Entrind/Web-KP-PomJen/Prototype_Alat/Flowchart_Alat.jpg

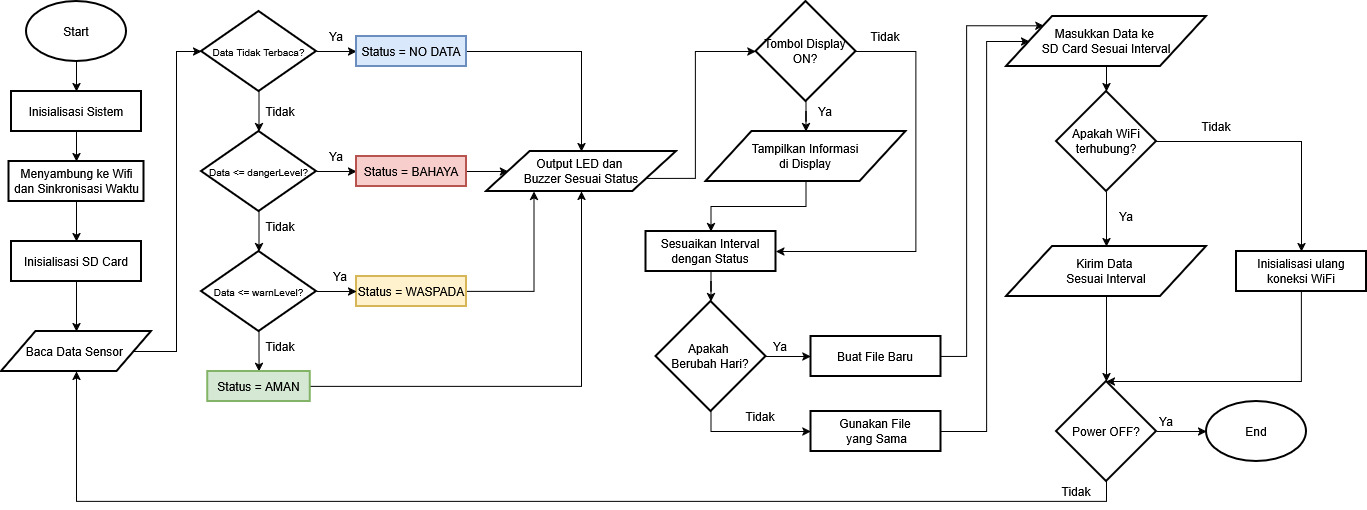
Prototype_Alat/Flowchart_Alat.jpg
