Entrind/Web-KP-PomJen/Prototype_Alat/Wiring Table.pdf

## Wiring Table

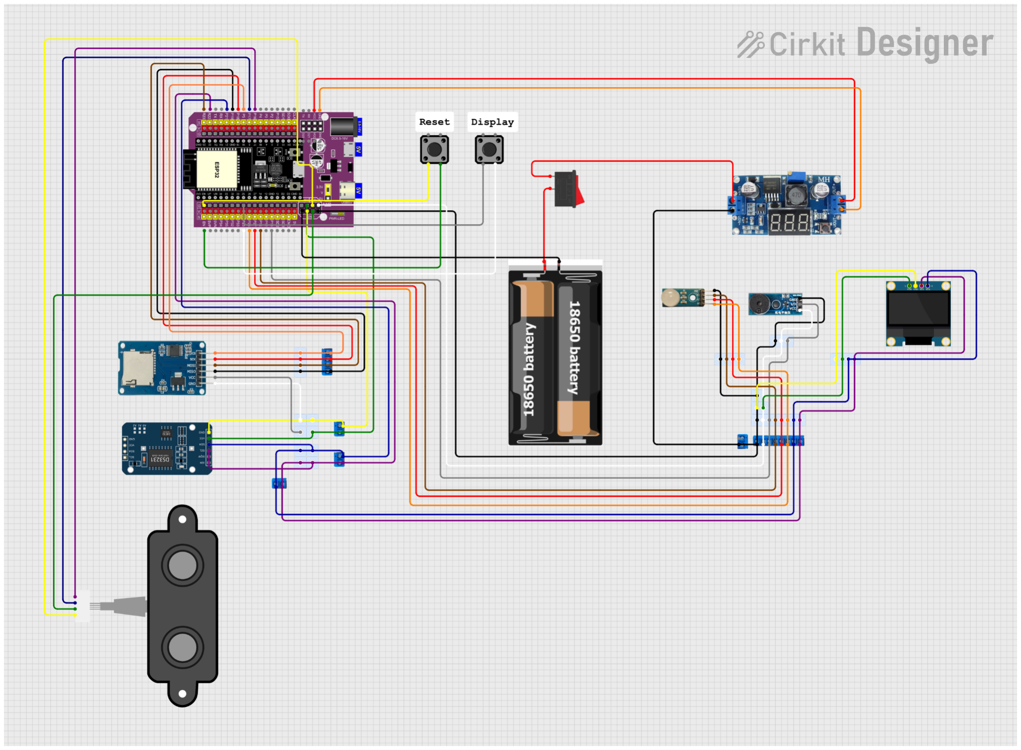
[picture p2: figure]

Komponen | PIN

Battery Case

Battery Case vin | Switch Pin 1
Battery Case ground | GND

LM2596 Step Down Converter

VIN+ | Switch Pin 2
VIN- | GND
VOUT+ | VCC
VOUT- | GND

SSD 1306 OLED Display

VCC | 3.3V
GND | GND
SCL | P22
SDA | P21

RGB LED

GND | GND
R | P14
G | P27
B | P26

Passive Buzzer

GND | GND
I/O | P13
VCC | 3.3V

SD Card Reader

CS | P5
SCK | P18
MOSI | P23
MISO | P19
VCC | 5V
GND | GND

RTC DS3231

GND | GND
VCC | 5V
SDA | P21
SCL | P22

Sensor Ultrasonik A02YYUW

VCC | 3.3V
GND | GND
RX | P17
TX | P16

Reset Button

Pin 1 | GND
Pin 2 | EN

Display Button

Pin 1 | GND
Pin 2 | P25
