Entrind/Web-KP-PomJen/Prototype_Alat/Ultrasonic Datalogger Wiring Diagram.png

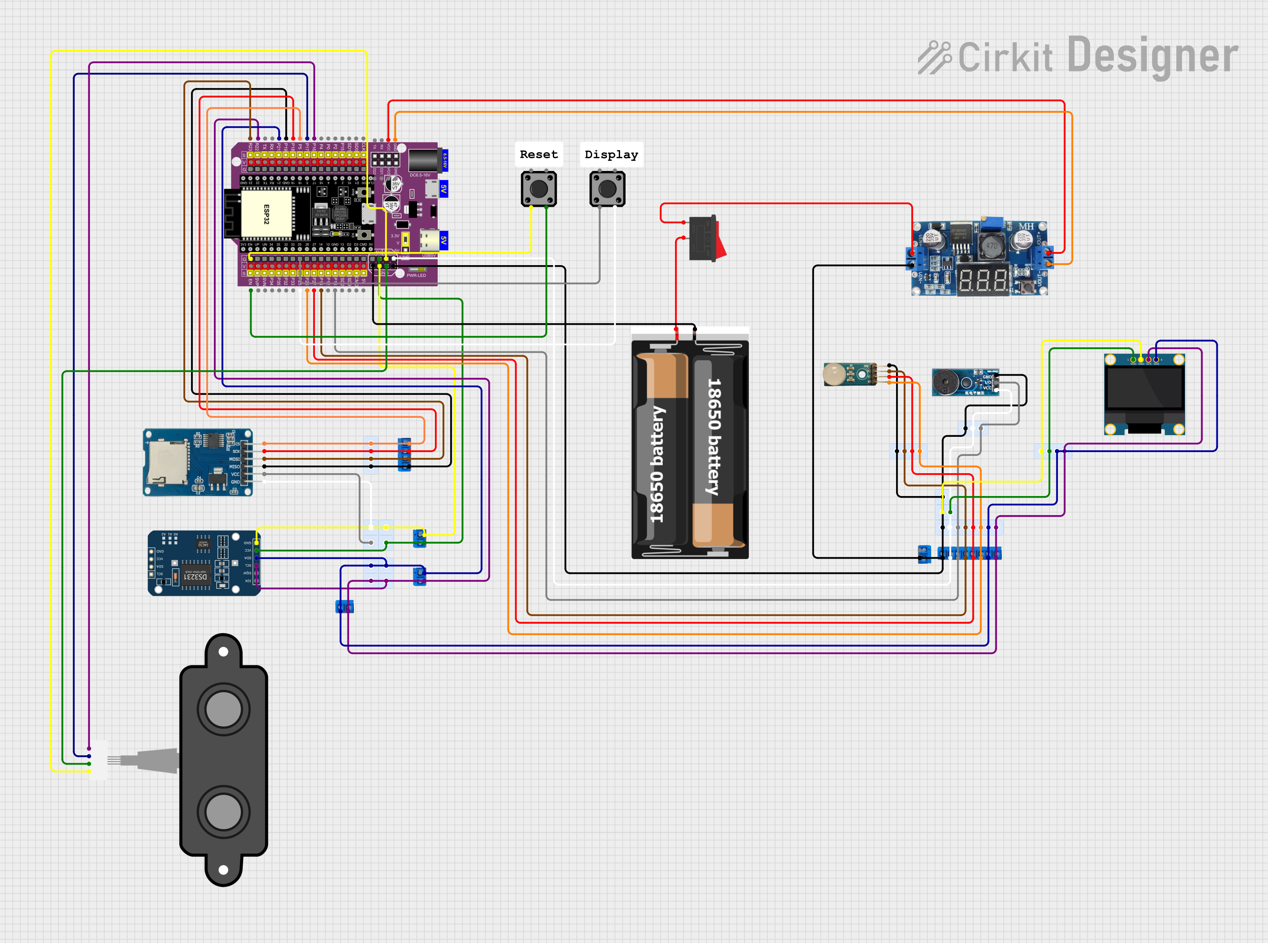
Prototype_Alat/Ultrasonic Datalogger Wiring Diagram.png
