Entrind/Web-KP-PomJen/(commit log)

2025-11-12 chore(ui): integrate Tailwind CSS v3 and apply base layout styles Configured tailwind.config.js and postcss.config.js, added index.css with Tailwind directives, and wired import in main.jsx. Applied 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
2026-01-20 Fix: Sensor mount distance adjustment and duplicated date fix in Riwayat.jsx
2026-02-02 Tambah Folder dan File-File Terkait Prototype Alat
2026-02-05 Tambah File Flowchart_Alat.jpg
2026-02-09 Update Flowchart
2026-02-09 Update Wiring Diagram
2026-02-09 Tambah File Wiring Table.pdf
2026-02-09 Tambah File Apps_Script
    - File untuk kode apps script di google sheet
2026-02-09 Update prototype README documentation
2026-05-04 feat: centralized multi-site config with localStorage and admin UI
    - add config/sites.js as single source of truth for site configuration
    - add AdminConfig.jsx for editing sheet ID, GID, and mount height via UI
    - update Overview.jsx to support multiple sites with parallel data fetching
    - update DetailPos.jsx to read mount height and sheet URL dynamically per site
    - update Riwayat.jsx to support per-site historical data view
    - update App.jsx with VITE_ENABLE_ADMIN env flag and admin nav link
